abhinavpradeep13/stm32-usb-hid-macropad/firmware/Core/Src/main.c

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
/* Includes ------------------------------------------------------------------*/
#include "main.h"
#include "usb_device.h"
#include "ui.h"

/* USER CODE BEGIN Includes */
#include "usbd_hid.h"
extern USBD_HandleTypeDef hUsbDeviceFS;

/* USER CODE END Includes */

/* USER CODE BEGIN PTD */
typedef struct {
  uint8_t cpu;
  uint8_t ram;
  uint8_t battery;
  uint8_t temp;
  uint8_t seq;
  uint8_t valid;
} PcStats_t;

/* USER CODE END PTD */

/* USER CODE BEGIN PD */
#define HID_STATE_IDLE 0U
/* USER CODE END PD */


/* USER CODE BEGIN PV */
PcStats_t pc_stats = { 0xFF, 0xFF, 0xFF, 0xFF, 0, 0 };
uint32_t  last_rx_tick = 0;
/* USER CODE END PV */

void SystemClock_Config(void);
static void MX_GPIO_Init(void);
/* USER CODE BEGIN 0 */
static void handle_rx_packet(void)
{
  if (hid_rx_buf[0] == 0x03U && hid_rx_buf[1] == 0x01U)
  {
    pc_stats.cpu     = hid_rx_buf[2];
    pc_stats.ram     = hid_rx_buf[3];
    pc_stats.battery = hid_rx_buf[4];
    pc_stats.temp    = hid_rx_buf[5];
    pc_stats.seq     = hid_rx_buf[6];
    pc_stats.valid   = 1U;
    last_rx_tick = HAL_GetTick();
  }
}
static uint8_t hid_ready(void)
{
  USBD_HID_HandleTypeDef *h = (USBD_HID_HandleTypeDef *)hUsbDeviceFS.pClassData;
  return (hUsbDeviceFS.dev_state == USBD_STATE_CONFIGURED) &&
         (h != NULL) && (h->state == HID_STATE_IDLE);
}

static uint8_t wait_hid_ready(uint32_t timeout_ms)
{
  uint32_t t0 = HAL_GetTick();
  while (!hid_ready()) {
    if ((HAL_GetTick() - t0) > timeout_ms) { return 0U; }
  }
  return 1U;
}

static void kbd_send(uint8_t mod, uint8_t key)
{
  uint8_t press[9]   = { 0x01, mod, 0x00, key, 0, 0, 0, 0, 0 };
  uint8_t release[9] = { 0x01, 0, 0, 0, 0, 0, 0, 0, 0 };

  if (!wait_hid_ready(50U))  { return; }
  USBD_HID_SendReport(&hUsbDeviceFS, press, 9);
  if (!wait_hid_ready(200U)) { return; }
  USBD_HID_SendReport(&hUsbDeviceFS, release, 9);
}
/* USER CODE END 0 */

/**
  * @brief  The application entry point.
  * @retval int
  */
int main(void)
{

  /* MCU Configuration--------------------------------------------------------*/

  /* Reset of all peripherals, Initializes the Flash interface and the Systick. */
  HAL_Init();

  /* Configure the system clock */
  SystemClock_Config();

  /* Initialize all configured peripherals */
  MX_GPIO_Init();
  MX_USB_DEVICE_Init();
  /* USER CODE BEGIN 2 */
  ui_init(kbd_send);
  /* USER CODE END 2 */

  /* Infinite loop */
  /* USER CODE BEGIN WHILE */
  while (1)
  {
    /* USER CODE END WHILE */

    /* USER CODE BEGIN 3 */
	    if (hid_rx_ready)
	    {
	      hid_rx_ready = 0U;
	      handle_rx_packet();
	    }
	    uint8_t link = pc_stats.valid && ((HAL_GetTick() - last_rx_tick) < 3000U);
	    ui_update_stats(pc_stats.cpu, pc_stats.ram, pc_stats.battery,
	                    pc_stats.temp, pc_stats.seq, link);
	    ui_poll();
  }
  /* USER CODE END 3 */
}

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
